janelia-modular-devices/mixed_signal_controller/README.org

#+TITLE: mixed_signal_controller
#+AUTHOR: Peter Polidoro
#+EMAIL: peter@polidoro.io

* Repository Information
  - Author :: Peter Polidoro
  - License :: BSD
