janelia-modular-devices/mixed_signal_controller/hardware/bom/bom_pcb_add.csv

Item | Function | Quantity | Description | PartNumber | Vendor
1 | ARDUINO | 2 | CONN HDR VERT 50POS .100 SNGL | SAM1055-50-ND | digikey
2 | ARDUINO | 1 | CABLE USB A-B MALE 1M 2.0 VERS | AE1462-ND | digikey
3 | POWER | 1 | AC/DC DESKTOP ADAPTER 12V 60W | T1200-P5P-ND | digikey
4 | POWER | 1 | LINE CORD 3 COND US | 993-1039-ND | digikey
5 | DISPLAY | 1 | LCD SERIAL 4X20 SIDE WHT BKLT | NHD-0420D3Z-NSW-BBW-V3-ND | digikey
6 | DISPLAY | 1 | 01x03 .100 SR STRAIGHT | 609-3461-ND | digikey
7 | DISPLAY | 1 | Jumper Wire - 0.1in 3-pin 4in | PRT-10363 | sparkfun
8 | ENCODER_C14 | 1 | ENCODER OPT 32PPR DET CABLE TYPE | 102-1914-ND | digikey
9 | ENCODER_C14 | 1 | KNOB CLR/MATTE.50 DIA .250 SHAFT | 226-3100-ND | digikey
10 | CONNECTORS | 4 | CONN IDC SKT 14POS W/POL 15 GOLD | AKC14H-ND | digikey
11 | CONNECTORS | 1 | CBL RIBN 10COND 0.050 MULTI 300 | MC10M-300-ND | digikey
12 | CONNECTORS | 2 | CONN IDC SKT 10POS W/POL 15 GOLD | AKC10H-ND | digikey
