janelia-modular-devices/mixed_signal_controller/hardware/schematic/mixed_signal_controller.pdf

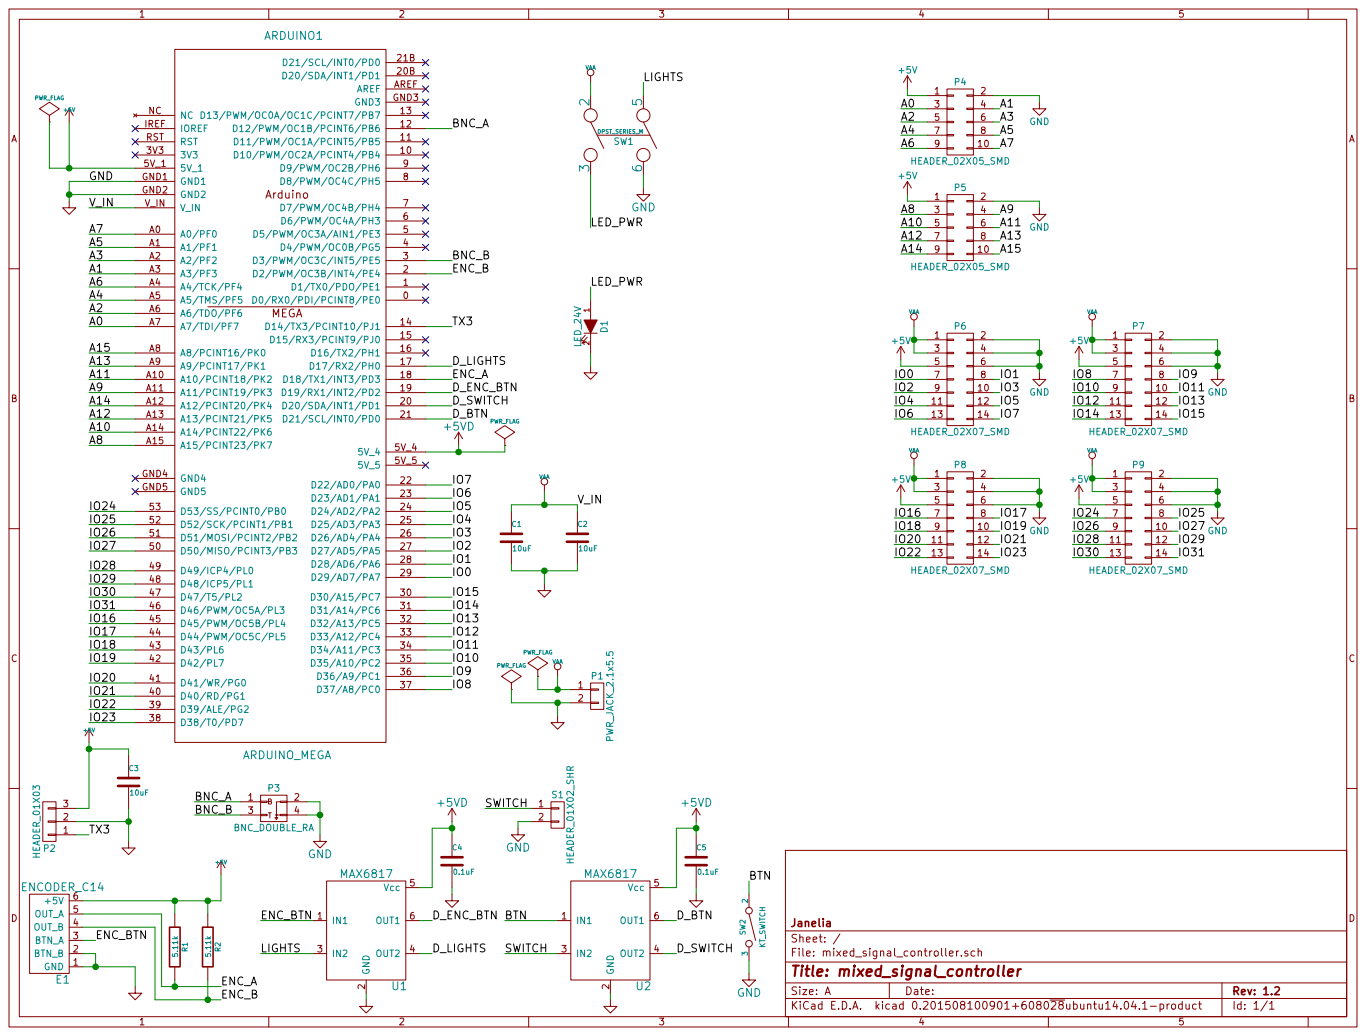
[picture p1: page 1]

File: mixed_signal_controller.sch Sheet: / Janelia
