janelia-modular-devices/mixed_signal_controller/(list of files, drawings)

Other design files:
hardware/mixed_signal_controller.dsn
