janelia-modular-devices/mixed_signal_controller/hardware/mixed_signal_controller.kicad_pcb

## KiCad design hardware/mixed_signal_controller.kicad_pcb (2015-08-11)

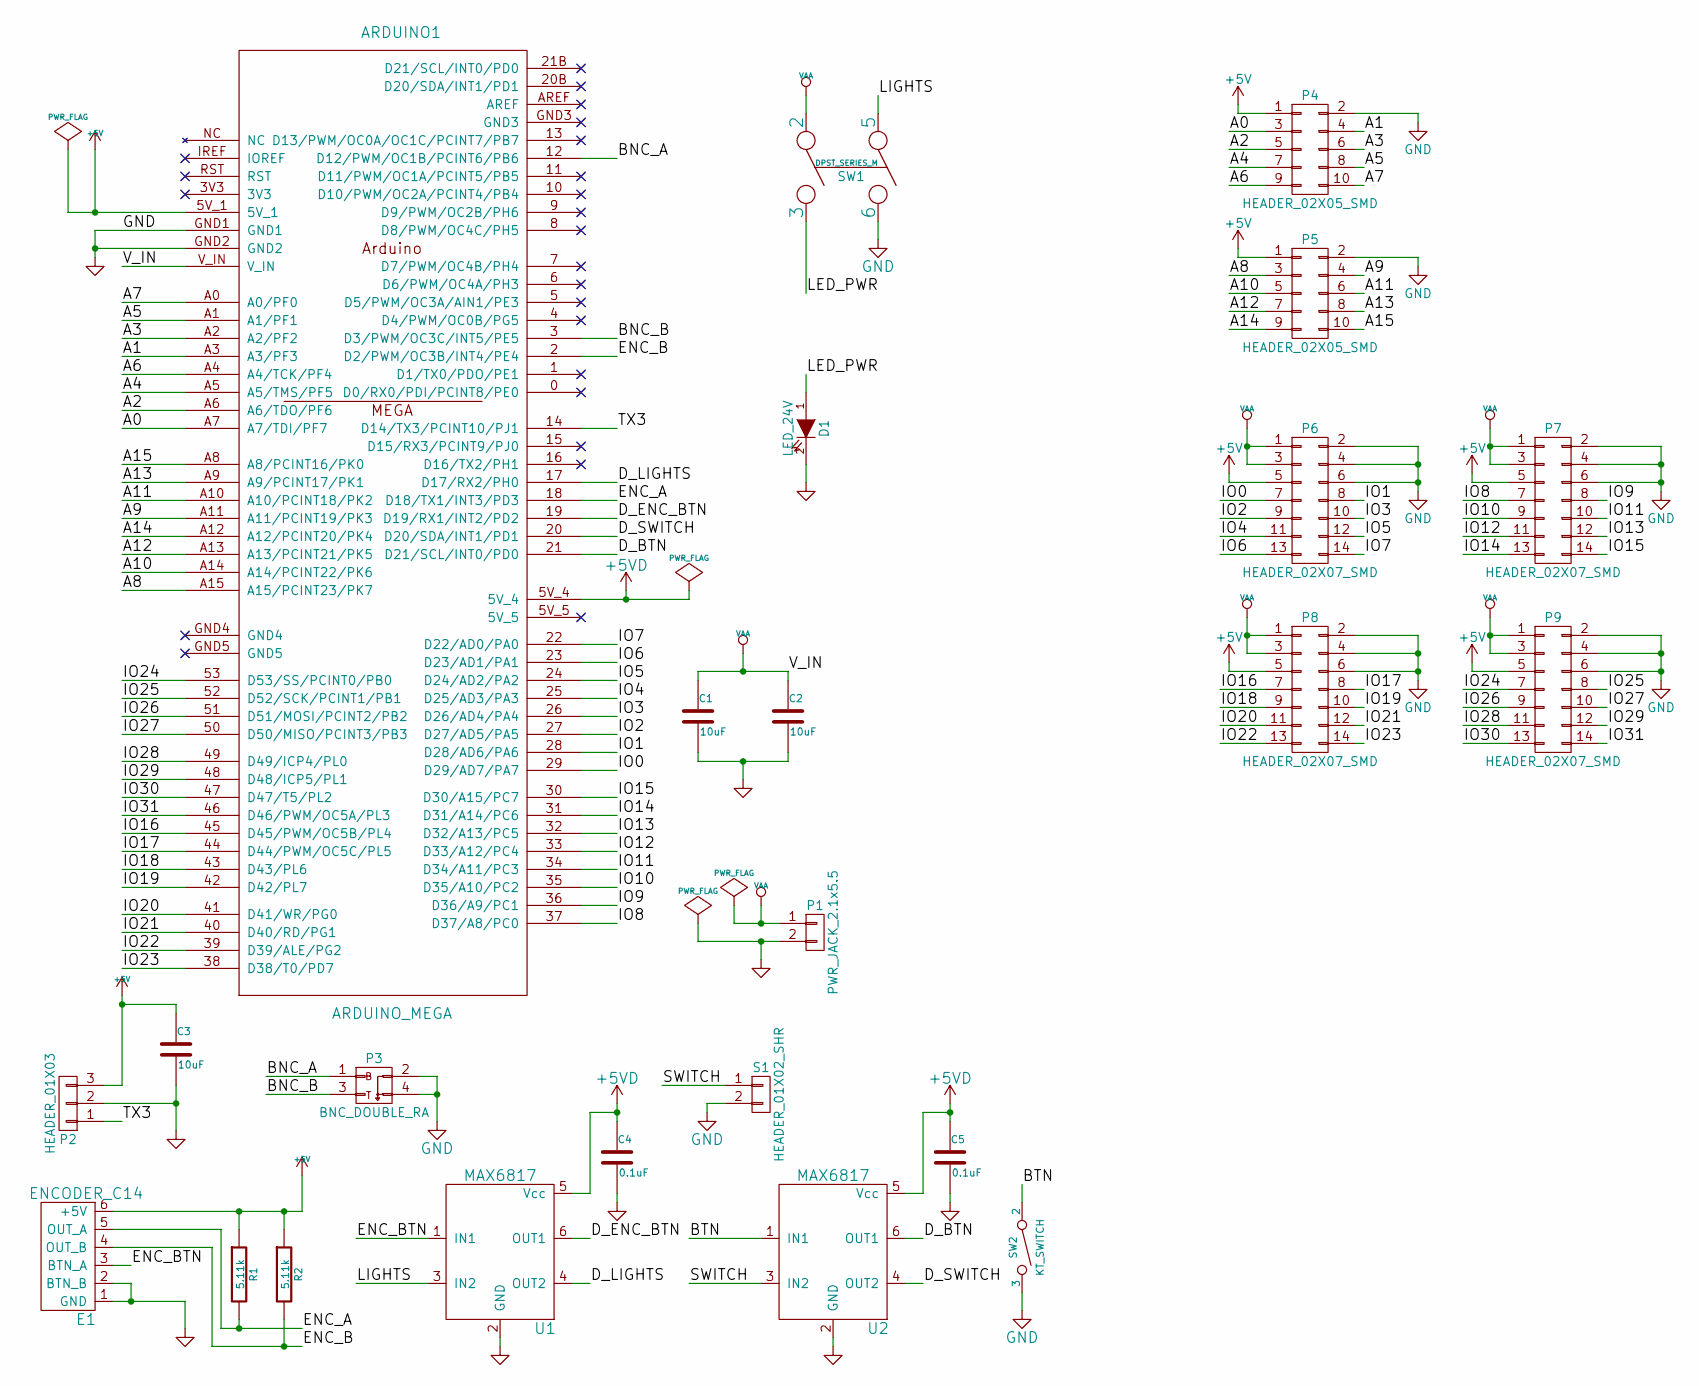
[picture p2: schematic mixed_signal_controller.sch]

Parts:
ARDUINO1: ARDUINO_MEGA; ARDUINO_MEGA_SHIELD; PartNumber 1050-1018-ND
C1, C2, C3: 10uF; SM1210; PartNumber 445-4536-1-ND
C4, C5: 0.1uF; SM1210; PartNumber 478-3586-1-ND
D1: LED_24V; LED_555-3XXX; PartNumber 350-1723-ND
E1: ENCODER_C14; Micro-MaTch_6_SMD; PartNumber A99474CT-ND
P1: PWR_JACK_2.1x5.5; DCJACK_2PIN_HIGHCURRENT; PartNumber CP-063AH-ND
P2: HEADER_01X03; Header_3_Pin; PartNumber 609-3461-ND
P3: BNC_DOUBLE_RA; BNC_DOUBLE; PartNumber ACX1655-ND
P4, P5: HEADER_02X05_SMD; HEADER_02x05_SMD; PartNumber S9185-ND
P6, P7, P8, P9: HEADER_02X07_SMD; HEADER_02x07_SMD; PartNumber S9186-ND
R1, R2: 5.11k; SM1210; PartNumber P5.11KAACT-ND
S1: HEADER_01X02_SHR; Header_Shrouded_2_Pin; PartNumber WM4800-ND
SW1: DPST_SERIES_M; PartNumber 360-3244-ND
SW2: KT_SWITCH; PartNumber CKN1860CT-ND
U1, U2: MAX6817; PartNumber MAX6817EUT+TCT-ND

Connections:
+5V: ARDUINO1.5V_1, C3.1, E1.6 (+5V), P2.3, P4.1, P5.1, P6.5, P7.5, P8.5, P9.5, R1.1, R2.1
+5VD: ARDUINO1.5V_4, C4.1, C5.1, U1.5 (Vcc), U2.5 (Vcc)
/A0: ARDUINO1.A7 (A7/TDI/PF7), P4.3
/A1: ARDUINO1.A3 (A3/PF3), P4.4
/A2: ARDUINO1.A6 (A6/TDO/PF6), P4.5
/A3: ARDUINO1.A2 (A2/PF2), P4.6
/A4: ARDUINO1.A5 (A5/TMS/PF5), P4.7
/A5: ARDUINO1.A1 (A1/PF1), P4.8
/A6: ARDUINO1.A4 (A4/TCK/PF4), P4.9
/A7: ARDUINO1.A0 (A0/PF0), P4.10
/A8: ARDUINO1.A15 (A15/PCINT23/PK7), P5.3
/A9: ARDUINO1.A11 (A11/PCINT19/PK3), P5.4
/A10: ARDUINO1.A14 (A14/PCINT22/PK6), P5.5
/A11: ARDUINO1.A10 (A10/PCINT18/PK2), P5.6
/A12: ARDUINO1.A13 (A13/PCINT21/PK5), P5.7
/A13: ARDUINO1.A9 (A9/PCINT17/PK1), P5.8
/A14: ARDUINO1.A12 (A12/PCINT20/PK4), P5.9
/A15: ARDUINO1.A8 (A8/PCINT16/PK0), P5.10
/BNC_A: ARDUINO1.12 (D12/PWM/OC1B/PCINT6/PB6), P3.1
/BNC_B: ARDUINO1.3 (D3/PWM/OC3C/INT5/PE5), P3.3
/BTN: SW2.2, U2.1 (IN1)
/D_BTN: ARDUINO1.21 (D21/SCL/INT0/PD0), U2.6 (OUT1)
/D_ENC_BTN: ARDUINO1.19 (D19/RX1/INT2/PD2), U1.6 (OUT1)
/D_LIGHTS: ARDUINO1.17 (D17/RX2/PH0), U1.4 (OUT2)
/D_SWITCH: ARDUINO1.20 (D20/SDA/INT1/PD1), U2.4 (OUT2)
/ENC_A: ARDUINO1.18 (D18/TX1/INT3/PD3), E1.5 (OUT_A), R1.2
/ENC_B: ARDUINO1.2 (D2/PWM/OC3B/INT4/PE4), E1.4 (OUT_B), R2.2
/ENC_BTN: E1.3 (BTN_A), U1.1 (IN1)
/IO0: ARDUINO1.29 (D29/AD7/PA7), P6.7
/IO1: ARDUINO1.28 (D28/AD6/PA6), P6.8
/IO2: ARDUINO1.27 (D27/AD5/PA5), P6.9
/IO3: ARDUINO1.26 (D26/AD4/PA4), P6.10
/IO4: ARDUINO1.25 (D25/AD3/PA3), P6.11
/IO5: ARDUINO1.24 (D24/AD2/PA2), P6.12
/IO6: ARDUINO1.23 (D23/AD1/PA1), P6.13
/IO7: ARDUINO1.22 (D22/AD0/PA0), P6.14
/IO8: ARDUINO1.37 (D37/A8/PC0), P7.7
/IO9: ARDUINO1.36 (D36/A9/PC1), P7.8
/IO10: ARDUINO1.35 (D35/A10/PC2), P7.9
/IO11: ARDUINO1.34 (D34/A11/PC3), P7.10
/IO12: ARDUINO1.33 (D33/A12/PC4), P7.11
/IO13: ARDUINO1.32 (D32/A13/PC5), P7.12
/IO14: ARDUINO1.31 (D31/A14/PC6), P7.13
/IO15: ARDUINO1.30 (D30/A15/PC7), P7.14
/IO16: ARDUINO1.45 (D45/PWM/OC5B/PL4), P8.7
/IO17: ARDUINO1.44 (D44/PWM/OC5C/PL5), P8.8
/IO18: ARDUINO1.43 (D43/PL6), P8.9
/IO19: ARDUINO1.42 (D42/PL7), P8.10
/IO20: ARDUINO1.41 (D41/WR/PG0), P8.11
/IO21: ARDUINO1.40 (D40/RD/PG1), P8.12
/IO22: ARDUINO1.39 (D39/ALE/PG2), P8.13
/IO23: ARDUINO1.38 (D38/T0/PD7), P8.14
/IO24: ARDUINO1.53 (D53/SS/PCINT0/PB0), P9.7
/IO25: ARDUINO1.52 (D52/SCK/PCINT1/PB1), P9.8
/IO26: ARDUINO1.51 (D51/MOSI/PCINT2/PB2), P9.9
/IO27: ARDUINO1.50 (D50/MISO/PCINT3/PB3), P9.10
/IO28: ARDUINO1.49 (D49/ICP4/PL0), P9.11
/IO29: ARDUINO1.48 (D48/ICP5/PL1), P9.12
/IO30: ARDUINO1.47 (D47/T5/PL2), P9.13
/IO31: ARDUINO1.46 (D46/PWM/OC5A/PL3), P9.14
/LED_PWR: D1.1 (A), SW1.3
/LIGHTS: SW1.5, U1.3 (IN2)
/SWITCH: S1.1, U2.3 (IN2)
/TX3: ARDUINO1.14 (D14/TX3/PCINT10/PJ1), P2.1
GND: ARDUINO1.GND1, ARDUINO1.GND2, C1.2, C2.2, C3.2, C4.2, C5.2, D1.2 (K), E1.1 (GND), E1.2 (BTN_B), P1.2, P2.2, P3.2, P3.4, P4.2, P5.2, P6.2, P6.4, P6.6, P7.2, P7.4, P7.6, P8.2, P8.4, P8.6, P9.2, P9.4, P9.6, S1.2, SW1.6, SW2.3, U1.2 (GND), U2.2 (GND)
VAA: ARDUINO1.V_IN, C1.1, C2.1, P1.1, P6.1, P6.3, P7.1, P7.3, P8.1, P8.3, P9.1, P9.3, SW1.2

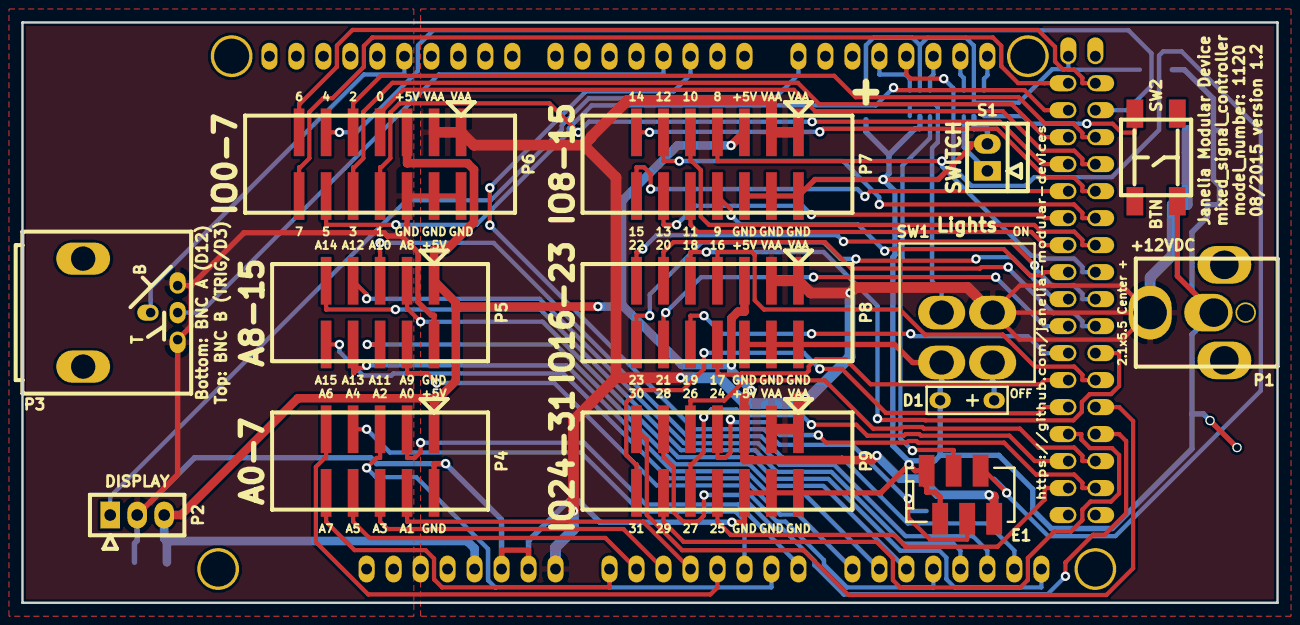
[picture p3: board mixed_signal_controller.kicad_pcb from above]

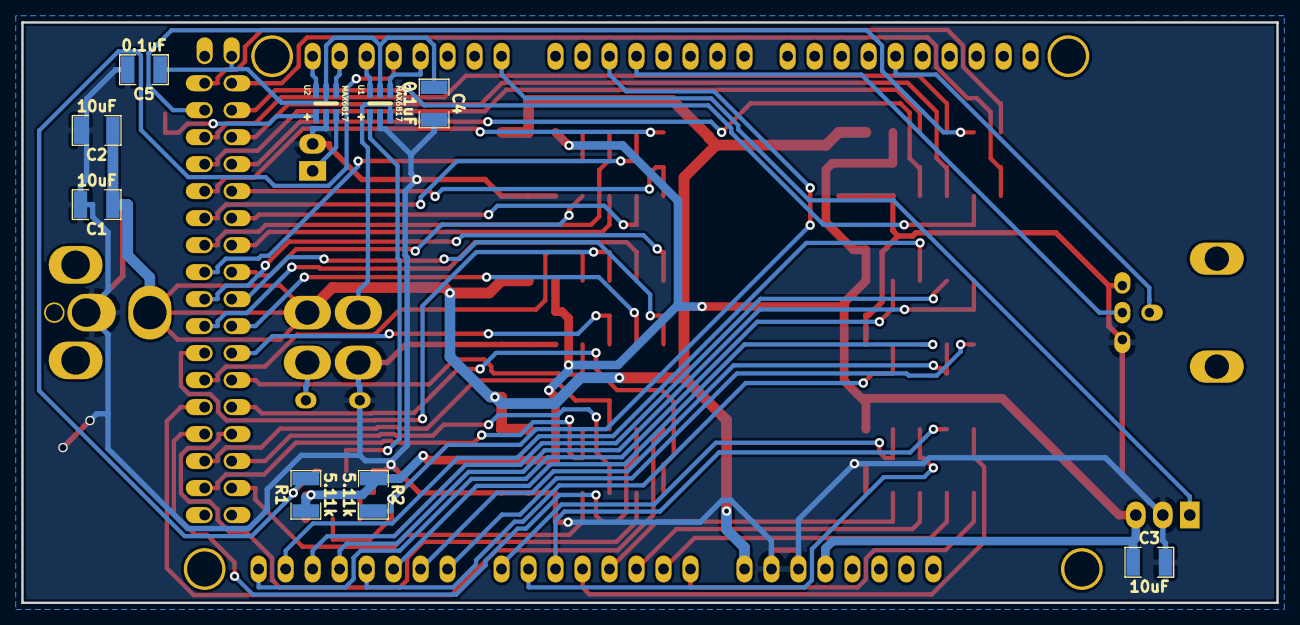
[picture p4: board mixed_signal_controller.kicad_pcb from below]

Board: 2 copper layers, 118.1 x 54.6 mm, 24 parts (9 on the bottom side), 66 nets.
