janelia-modular-devices/mixed_signal_controller/(commit log)

2015-05-01 Initial commit of base files.
    [mixed_signal_controller.kicad_pcb, mixed_signal_controller.sch]
2015-05-01 Finished pcb v1.0.
    [mixed_signal_controller.dsn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]
2015-05-01 Initial bom commit.
    [bom_pcb.csv, bom_pcb_add.csv, digikey_order_pcb.csv, digikey_order_pcb_add.csv]
2015-05-05 Updated bom_pcb_add.
    [bom_pcb_add.csv, digikey_order_pcb_add.csv]
2015-05-08 Finished pcb v1.1.
    [bom_pcb.csv, bom_pcb_add.csv, digikey_order.csv, digikey_order_pcb.csv, digikey_order_pcb_add.csv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]
2015-05-12 Changed order quantities.
    [digikey_order.csv]
2015-05-12 Added 12V power supply to bom.
    [bom_pcb_add.csv, digikey_order.csv]
2015-05-22 Added standalone_interface frame toggleChannel.
2015-05-22 Added standalone frames setAllChannelsOn and setAllChannelsOff.
2015-06-18 Average the analog input over several samples.
2015-06-23 Use new analogSampled function instead of simple analogRead.
    [digikey_order_pcb_add.csv]
2015-07-02 Increasing analog sample count creates serial response errors.
    [Constants.cpp]
2015-07-13 JaneliaSciComp -> janelia-modular-devices.
    [mixed_signal_controller.kicad_pcb]
2015-08-04 Added filtering to the analog inputs.
2015-08-11 SPST switch -> DPST switch.
    [bom_pcb.csv, digikey_order_pcb.csv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]
2015-09-18 Updated firmware to match pcb v1.2.
2016-09-21 pcb -> hardware.
    [bom_pcb.csv, bom_pcb_add.csv, digikey_order.csv, digikey_order_pcb.csv, digikey_order_pcb_add.csv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]
